hjime008/STM32-Oscilloscope/README.md

# STM32-Oscilloscope
Repo for a small project made using an STM32 "blue pill" board. Project is an oscilloscope with a few additional features like current measuring.
